daehyeok/eyocean-ha/CC1101_specs/CC1101-Pin-out-1-600x290.jpg

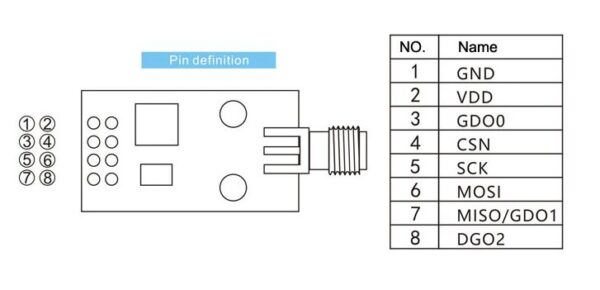
CC1101_specs/CC1101-Pin-out-1-600x290.jpg
