daehyeok/eyocean-ha/CC1101_specs/CC1101-Product-size-600x313.jpg

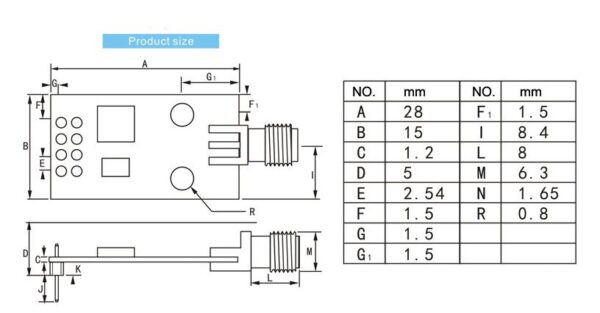
CC1101_specs/CC1101-Product-size-600x313.jpg
