daehyeok/eyocean-ha/CC1101_specs/CC1101-Schematic-600x306.jpg

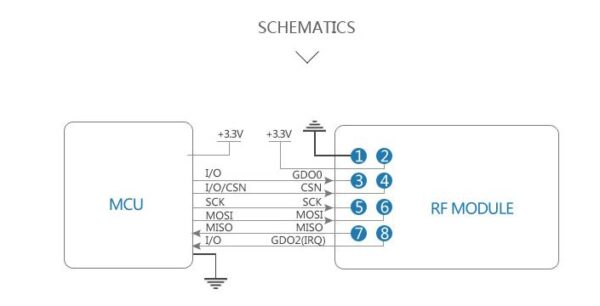
CC1101_specs/CC1101-Schematic-600x306.jpg
