daehyeok/eyocean-ha/pcb/production/eyocean_carrier_3d_top.png

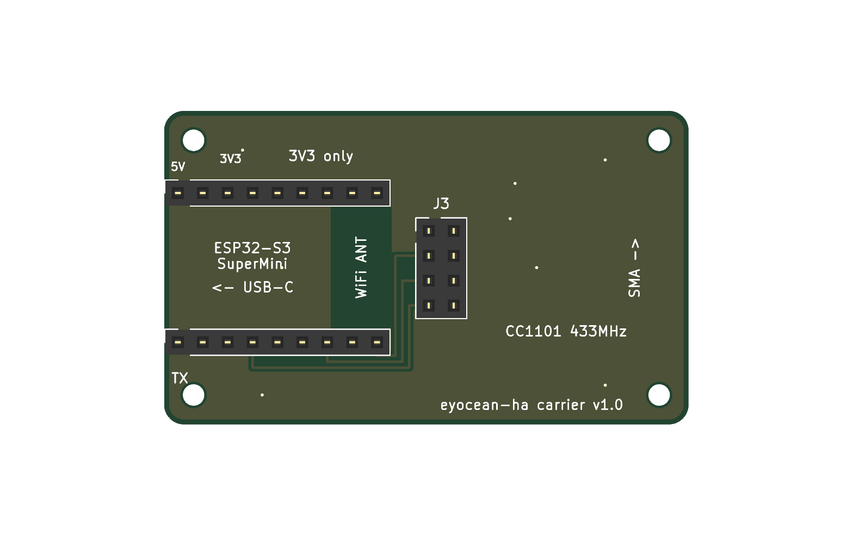
pcb/production/eyocean_carrier_3d_top.png
