daehyeok/eyocean-ha/cad/export/enclosure_lid.3mf

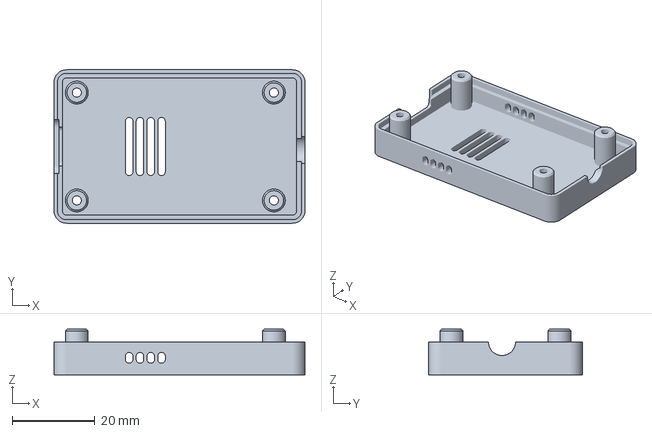
[picture p6: CAD file, 2026-10-19]
cad/export/enclosure_lid.3mf
60.5 x 37.0 x 11.0 mm
