daehyeok/eyocean-ha/pcb/production/eyocean_carrier.step

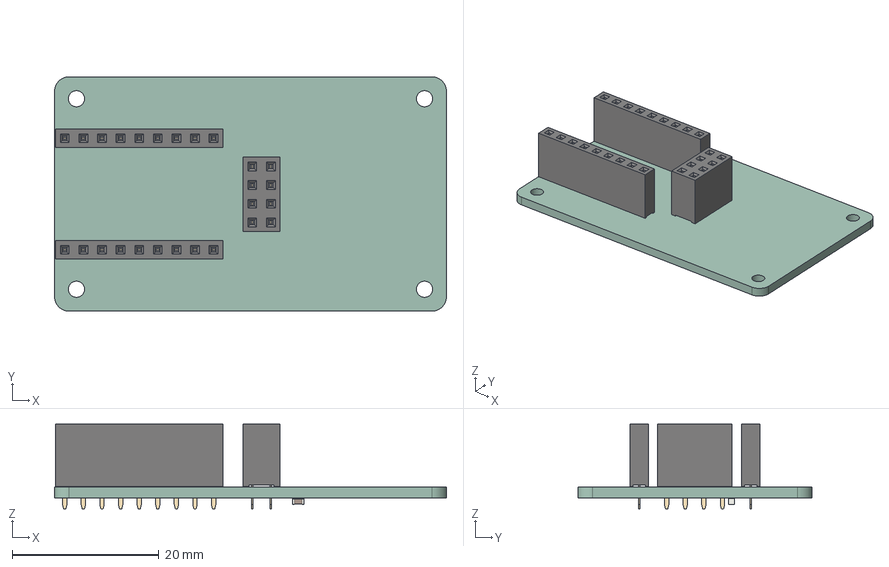
[picture p7: CAD file, 2026-10-19]
pcb/production/eyocean_carrier.step
53.5 x 32.0 x 11.6 mm
PinSocket_2x04_P2.54mm_Vertical
PinSocket_1x09_P2.54mm_Vertical x 2
C_0603_1608Metric
eyocean_carrier_PCB
