daehyeok/eyocean-ha/(list of files, cad)

Other CAD files:
cad/export/enclosure_bottom.stl
cad/export/enclosure_lid.stl
