daehyeok/eyocean-ha/pcb/production/eyocean_carrier_schematic.pdf

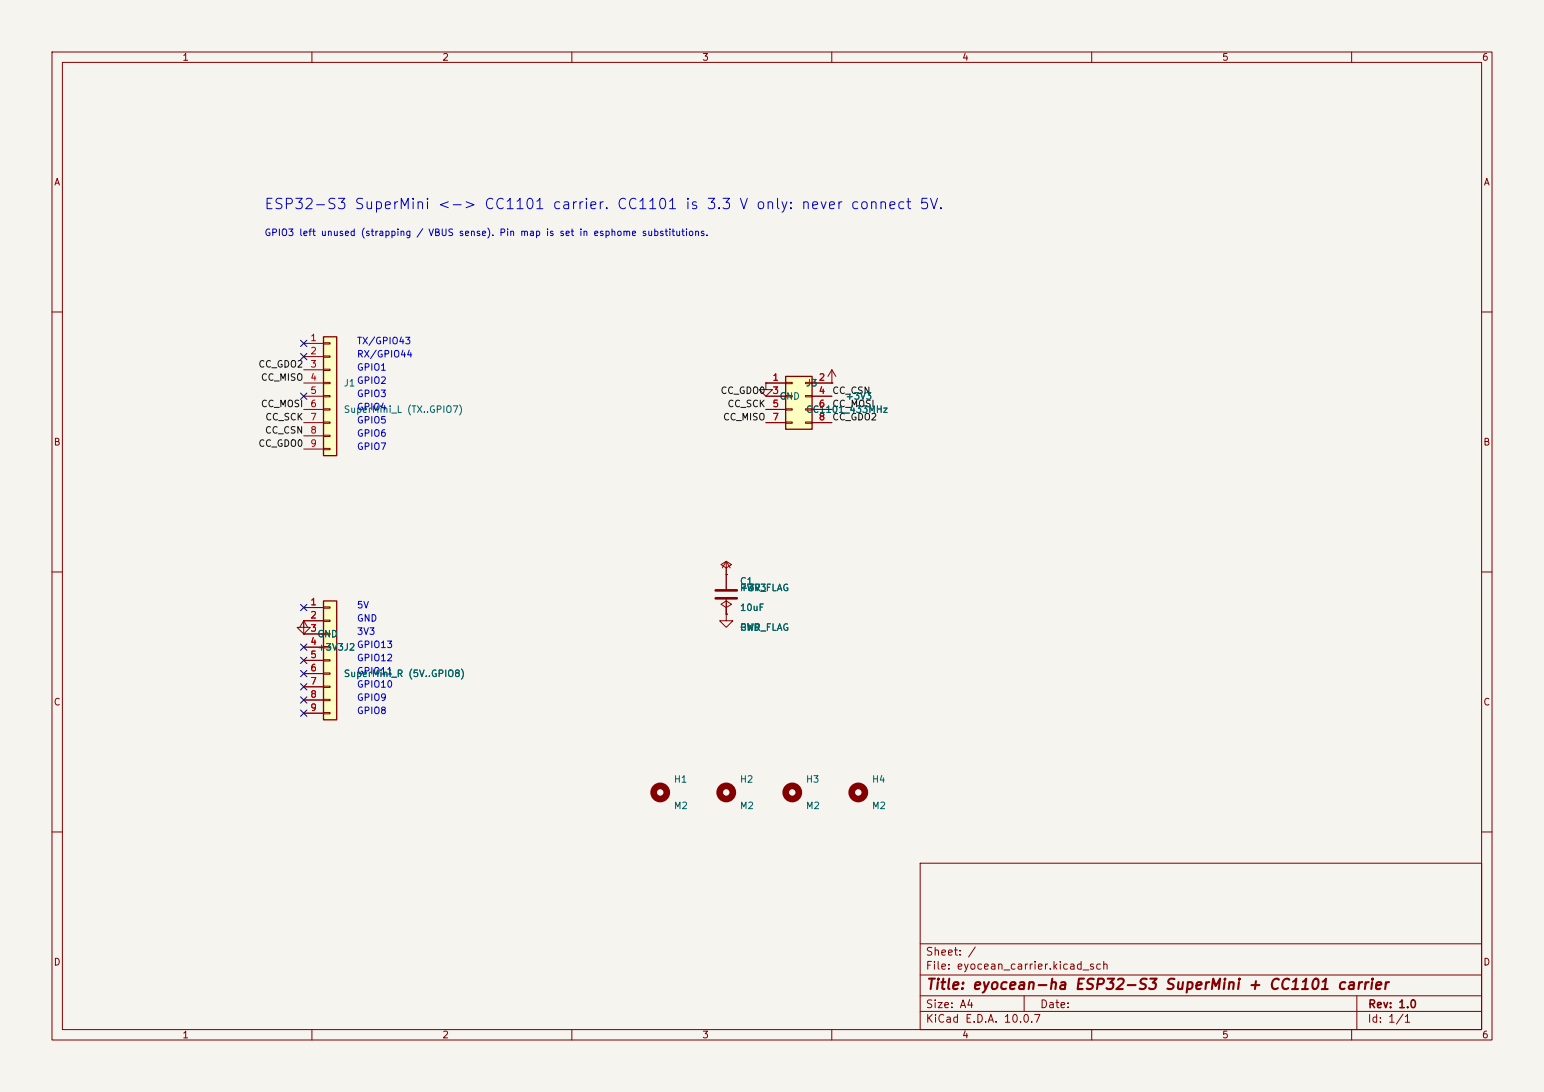
[picture p9: page 1]

TX/GPIO43 GPIO13 ESP32-S3 SuperMini <-> CC1101 carrier. CC1101 is 3.3 V only: never connect 5V. GPIO3 left unused (strapping / VBUS sense). Pin map is set in esphome substitutions. GPIO2 GPIO1 GND +3V3J2

Sheet: /
File: eyocean_carrier.kicad_sch
Title: eyocean-ha ESP32-S3 SuperMini + CC1101 carrier

Size: A4 | Rev: 1.0
KiCad E.D.A. 10.0.7 | Id: 1/1
