daehyeok/eyocean-ha/pcb/eyocean_carrier.kicad_pcb

## KiCad design pcb/eyocean_carrier.kicad_pcb (2026-10-19)

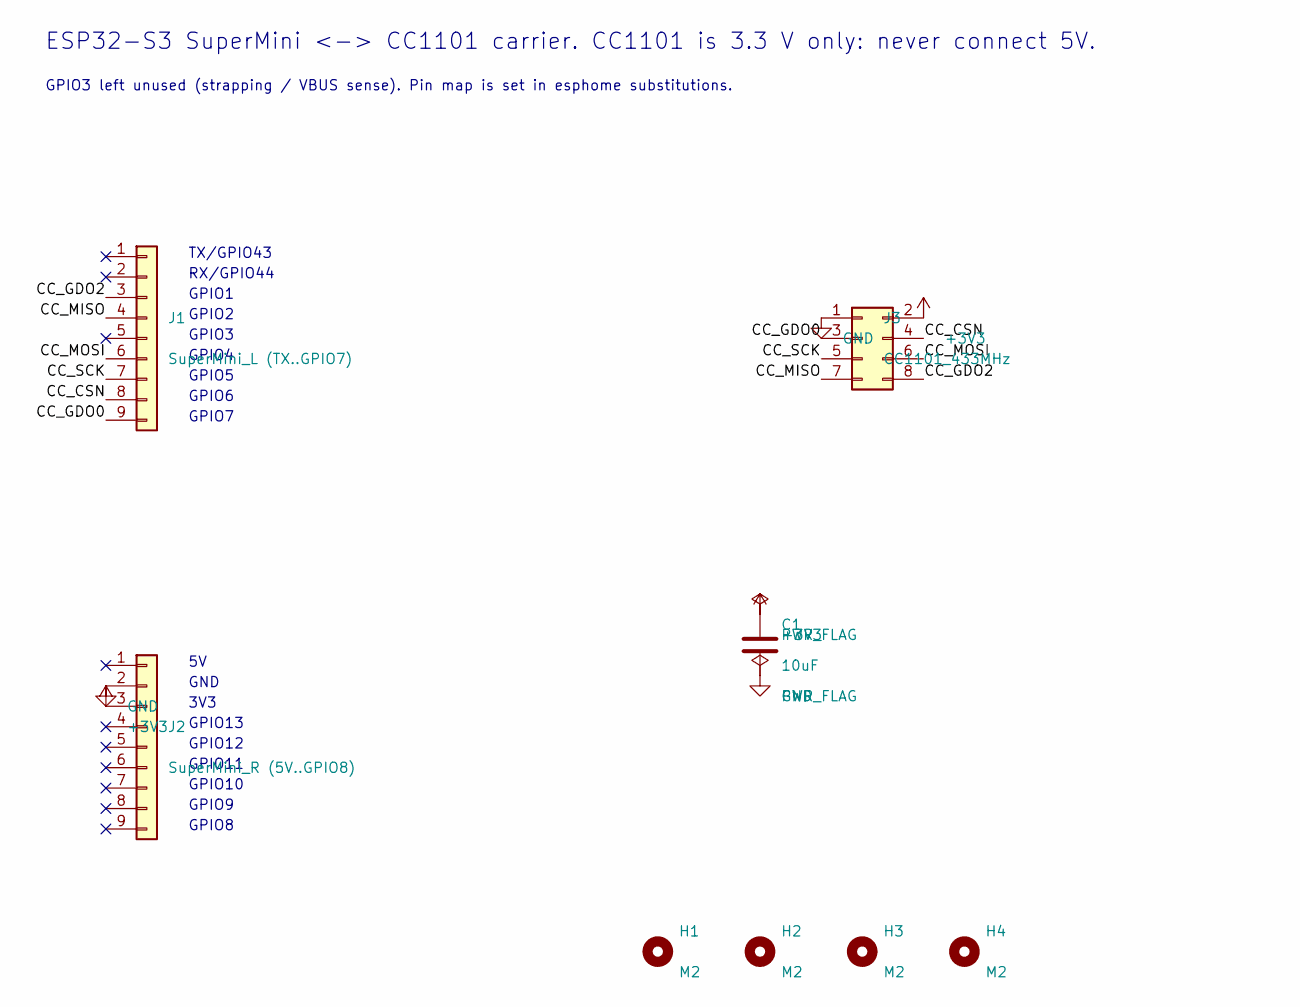
[picture p10: schematic eyocean_carrier.kicad_sch, eyocean-ha ESP32-S3 SuperMini + CC1101 carrier]

Parts:
C1: 10uF; C_0603_1608Metric_Pad1.08x0.95mm_HandSolder
H1, H2, H3, H4: M2; MountingHole_2.2mm_M2
J1: SuperMini_L (TX..GPIO7); PinSocket_1x09_P2.54mm_Vertical
J2: SuperMini_R (5V..GPIO8); PinSocket_1x09_P2.54mm_Vertical
J3: CC1101_433MHz; CC1101_Socket_2x04_P2.54mm_TopView

Connections:
+3V3: C1.1, J2.3, J3.2
/CC_CSN: J1.8, J3.4
/CC_GDO0: J1.9, J3.3
/CC_GDO2: J1.3, J3.8
/CC_MISO: J1.4, J3.7
/CC_MOSI: J1.6, J3.6
/CC_SCK: J1.7, J3.5
GND: C1.2, J2.2, J3.1

Notes on the sheet:
TX/GPIO43
RX/GPIO44
GPIO1
GPIO2
GPIO3
GPIO4
GPIO5
GPIO6
GPIO7
GND
3V3
GPIO13
GPIO12
GPIO11
GPIO10
GPIO9
GPIO8
ESP32-S3 SuperMini <-> CC1101 carrier. CC1101 is 3.3 V only: never connect 5V.
GPIO3 left unused (strapping / VBUS sense). Pin map is set in esphome substitutions.

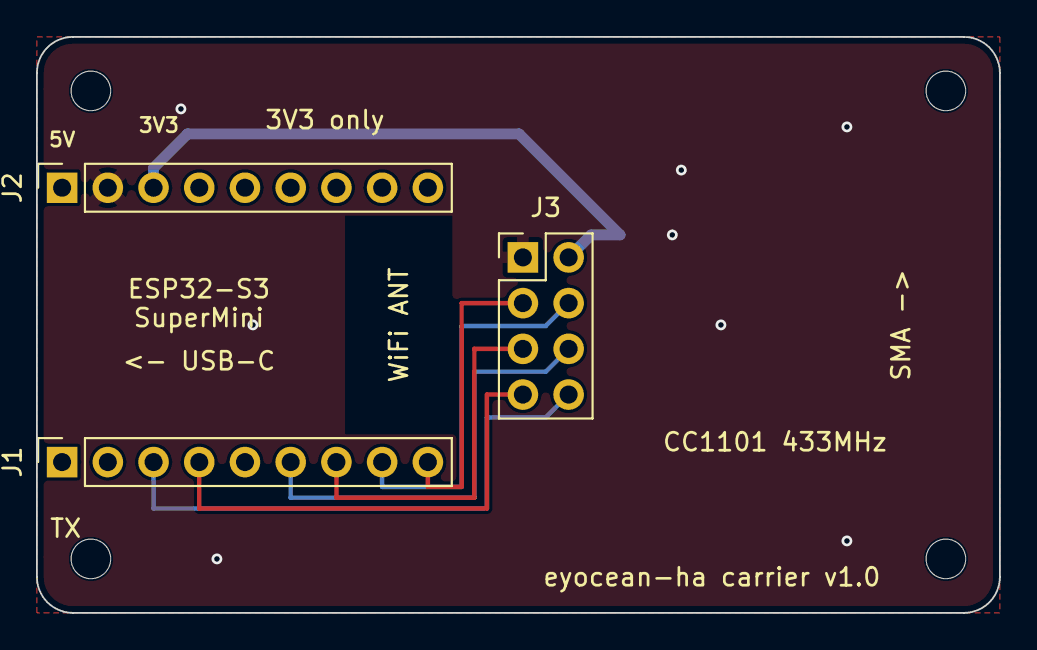
[picture p11: board eyocean_carrier.kicad_pcb from above]

Board: 2 copper layers, 53.5 x 32.0 mm, 8 parts (1 on the bottom side), 8 nets.
