daehyeok/eyocean-ha/(commit log)

2026-10-19 chore: add OpenSpec workflow and agent skills
    Set up the OpenSpec spec-driven workflow (openspec/config.yaml) and the
    agent skills it and the hardware work use (KiCad routing, part search,
    OpenSCAD/BOSL2). Ignore machine-local agent rules, KiCad temporaries and
    macOS ._ metadata files.
2026-10-19 feat: ESP32-S3 SuperMini + CC1101 carrier board, case and Pzloz preset
    Carrier PCB (pcb/): 56 x 32 mm, 2 layers, female sockets for an ESP32-S3
    SuperMini and a CC1101 433 MHz SMA module (CC1101_specs/), 100 nF + 10 uF
    on the CC1101 VDD, four M2 corner holes and no copper under the
    SuperMini's chip antenna. The KiCad files are generated from
    pcb/scripts/board_def.py; pcb/scripts/build.sh regenerates them, runs
    ERC and DRC with schematic parity, and exports Gerbers, drill files,
    SVGs, a 3D render and a STEP model to pcb/production/.
    The CC1101 uses the SuperMini's left header column, ordered so each
    copper layer is planar: GDO0=GPIO7, CSN=GPIO6, SCK=GPIO5, MOSI=GPIO4,
    MISO=GPIO2, GDO2=GPIO1.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
2026-10-19 chore: archive add-pzloz-hardware-and-case
    Sync its delta specs into openspec/specs (connecting-pcb, enclosure-case,
    pzloz-firmware-config) and move the change to
    openspec/changes/archive/2026-10-19-add-pzloz-hardware-and-case.
2026-10-19 build: JLCPCB Gerber set and printable STL exports
    build.sh now writes pcb/production/eyocean_carrier_jlcpcb.zip following
    JLCPCB's KiCad guide (Protel extensions, no X2/netlist attributes,
    Excellon mm, absolute origin, separate PTH/NPTH) instead of the generic
    gerbers/ folder. cad/export.sh exports the base and lid as STL and 3MF
    in print orientation (both now sit on z = 0).
2026-10-19 pcb: use 0603 for both decoupling capacitors
    Move the 10 uF CC1101 decoupling cap from 0805 to the same 0603
    hand-solder footprint as the 100 nF (use X5R, >= 6.3 V). Regenerated
    schematic and board (3V3 rail and pad-1 positions unchanged), ERC/DRC
    with schematic parity clean, JLCPCB Gerbers re-exported.
2026-10-19 pcb: single 10 uF decoupling capacitor
    The CC1101 module already carries its own 100 nF next to the chip, so
    the carrier only needs a local bulk cap for the TX current bursts. Drop
    C2 and make C1 a 10 uF 0603 X5R 10 V (LCSC C19702, Samsung
    CL10A106KP8NNNC); its GND stitching via now sits beside its pad.
    Regenerated schematic and board, ERC/DRC with schematic parity clean,
    JLCPCB Gerbers re-exported.
2026-10-19 feat: direct-solder stack-up, centred CC1101 header, cad build guide
    Both modules are now soldered straight onto the carrier through their
    male headers (no sockets), so the case is recomputed from a direct-solder
    stack-up: separate SuperMini / CC1101 header-spacer heights, SMA axis
    offset, pin-tail room. Case 60.5 x 37 x 18.1 mm (was 26.6 mm tall).
    - M2 x 16 flat-head bolts sit flush; the hex nut pocket depth is now
    automatic so the head stays flush when measured spacers shift the
    roof, and base standoffs are 6.5 mm for a printable nut wall.
    - Fit checks refuse to export when the bolt, pin tails, SMA/carrier
    clearance or nut wall don't fit.
    - Carrier shortened to 53.5 mm so the CC1101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
2026-10-19 chore: archive direct-solder-modules-and-cad-guide
    Sync its delta specs into openspec/specs: connecting-pcb (socket
    requirement replaced by direct soldering; single 10 uF cap; 53.5 mm
    board, 47.5 x 26 mm holes) and enclosure-case (direct-solder height
    stack-up and cad/README.md build guide added; M2 x 16 flush bolts).
    Move the change to openspec/changes/archive/.
2026-10-19 pcb: move 10 uF decoupling cap to the back, 3V3 on B.Cu
    C1 now sits on B.Cu under its old spot, clear of the CC1101 module and
    easy to solder after both modules are fitted; the case leaves 3.5 mm
    under the board (cap <= 0.95 mm tall). +3V3 is routed on B.Cu at 0.6 mm
    along the north margin to C1 and on to CC1101 VDD.
    The change was made in the KiCad GUI and is ported into gen_pcb.py
    (flip_to_back + new 3V3 route) so build.sh reproduces it; the
    regenerated board matches the GUI edit segment-for-segment. ERC/DRC
    with schematic parity clean; JLCPCB Gerbers re-exported. Assembly
    notes in README.md and cad/README.md updated.
